Elecrow-RD/AI_Camera_Development_Board_Vision_Sensor_Board_Powered_By_ESP32/factory_firmware/readme.md

# How to install the factory demo firmware with flash download tool?

#### 1.Preparation:

- USB C cable
- Laptop/PC
- ai camera
- Flash download tool

Check whether the materials on the PCBA board are defective. Such as less material, false welding, tin and other bad phenomena.

#### 2.Flash the firmware 

##### Step1 Connect the ESP32 display to the laptop/PC with USB-C cable. The power indicator will light up.

##### Step2 Open the flash download tool. 

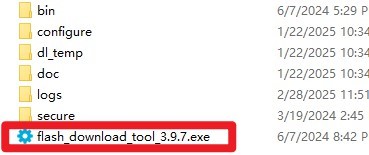
[picture p1: factory_firmware/flash02.jpg]
flash02


For the  Crowpanel Advance HMI ESP32 AI Display, the chip select ESP32-S3:

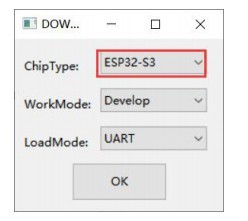
[picture p2: factory_firmware/flash03.jpg]
flash03


##### Step3

①Choose the firmware files;

flash0

②Enter the address: 

boot_app0.bin------0xe000

xxxx.ino.bin--------0x10000

xxxx.ino.bootloader.bin------0x0

xxxx.ino.partitions.bin-------0x8000

③Check the firmware files;

④Select the correct port number;

⑤Click “Start” to download

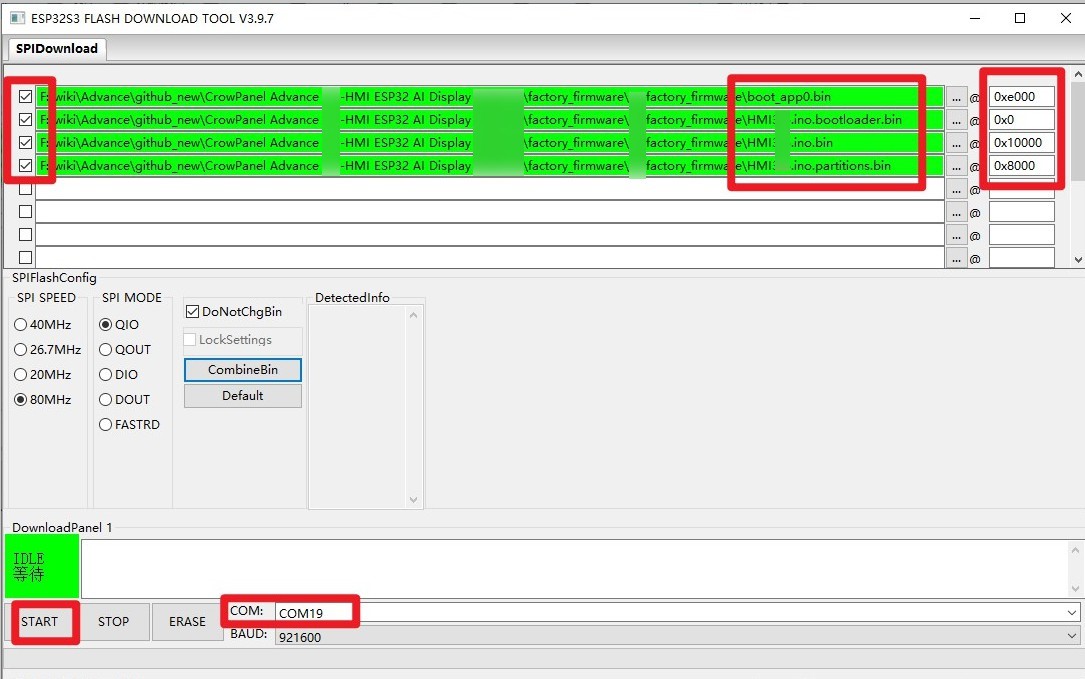
[picture p3: factory_firmware/flash1.jpg]
flash1


##### Step5 After the download is complete, blue FINISH will be displayed, and the progress bar at the bottom shows that it has come to an end.

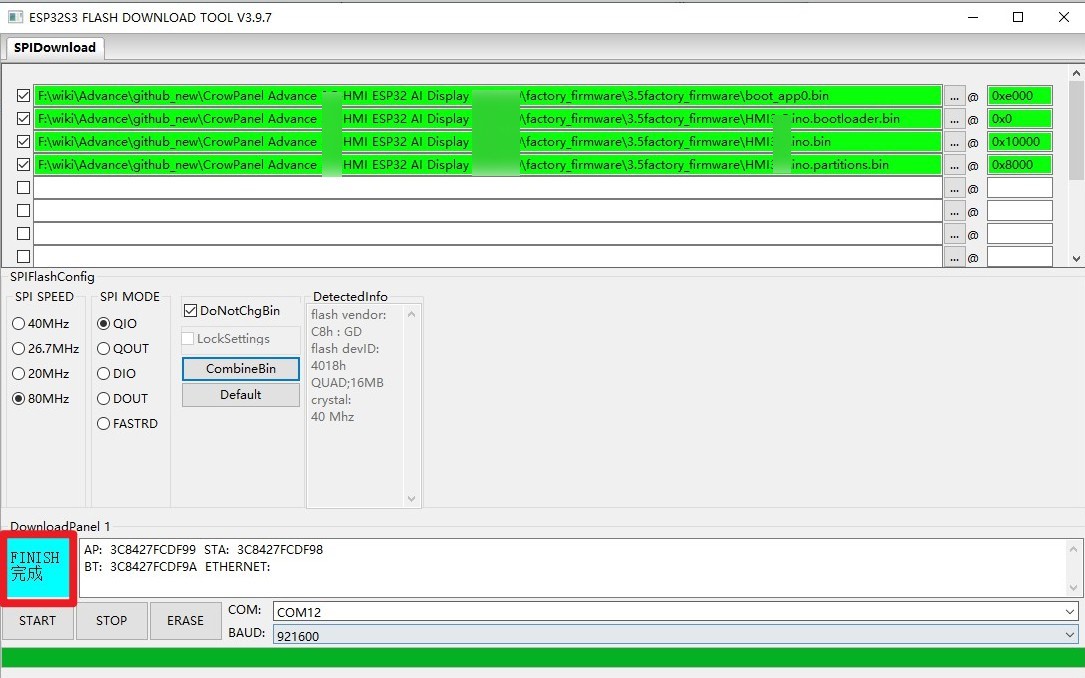
[picture p4: factory_firmware/flash2.jpg]
flash2


##### Step6 Press the reset button to show the demo.
