Elecrow-RD/AI_Camera_Development_Board_Vision_Sensor_Board_Powered_By_ESP32/example/V1.1/AI_Camera_V1.1_Full_Function/AI_Camera-V1.1-Arduino/README.md

# AI_Camera
## 介绍
AI_Camera作为集成AI在线识别和AI聊天机器人的入口，利用大模型的AI能力实现图片识别和在线对话。
## 功能介绍
- 支持HTTP协议发送图片与识别
- 支持Websocket通信协议
- 采用 OPUS 音频编解码
- 基于流式 ASR + LLM + TTS 架构的语音交互
- LCD 显示屏，支持表情显示
- 通过设备端 IOT 实现设备控制（音量、灯光、GPIO 等）
## 硬件版本
- 支持的硬件出货版本：AI_Camera V1.1
## 开发环境
- Arduino IDE 2.3.4
- ESP32版本：3.2.0
- 使用Windows环境开发
## Other
