Elecrow-RD/AI_Camera_Development_Board_Vision_Sensor_Board_Powered_By_ESP32/example/V1.1/AI_Camera_V1.1_Full_Function/AI_Camera-V1.1-Arduino/README_英语（美国）.md

# AI_Camera
## Introduction
AI_Camera serves as an entry point that integrates online AI recognition and an AI chatbot, leveraging the capabilities of large AI models to provide image recognition and online conversations.
## Features
- Supports sending and recognizing images over HTTP
- Supports the WebSocket communication protocol
- Uses the OPUS audio codec
- Voice interaction based on a streaming ASR + LLM + TTS architecture
- LCD display with support for displaying expressions
- Device control through device-side IoT (volume, lighting, GPIO, etc.)
## Hardware Version
- Supported production hardware version: AI_Camera V1.1
## Development Environment
- Arduino IDE 2.3.4
- ESP32 version: 3.2.0
- Developed in a Windows environment
## Other
