Elecrow-RD/AI_Camera_Development_Board_Vision_Sensor_Board_Powered_By_ESP32/factory_firmware/AI-Camear-V1.1-ELECROW-Firmware-20260824/readme.png

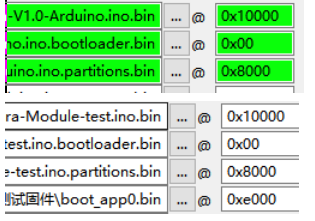
factory_firmware/AI-Camear-V1.1-ELECROW-Firmware-20260824/readme.png
