Elecrow-RD/AI_Camera_Development_Board_Vision_Sensor_Board_Powered_By_ESP32/Eagle_SCH&PCB/1.0/AI Camera V1.0.pdf

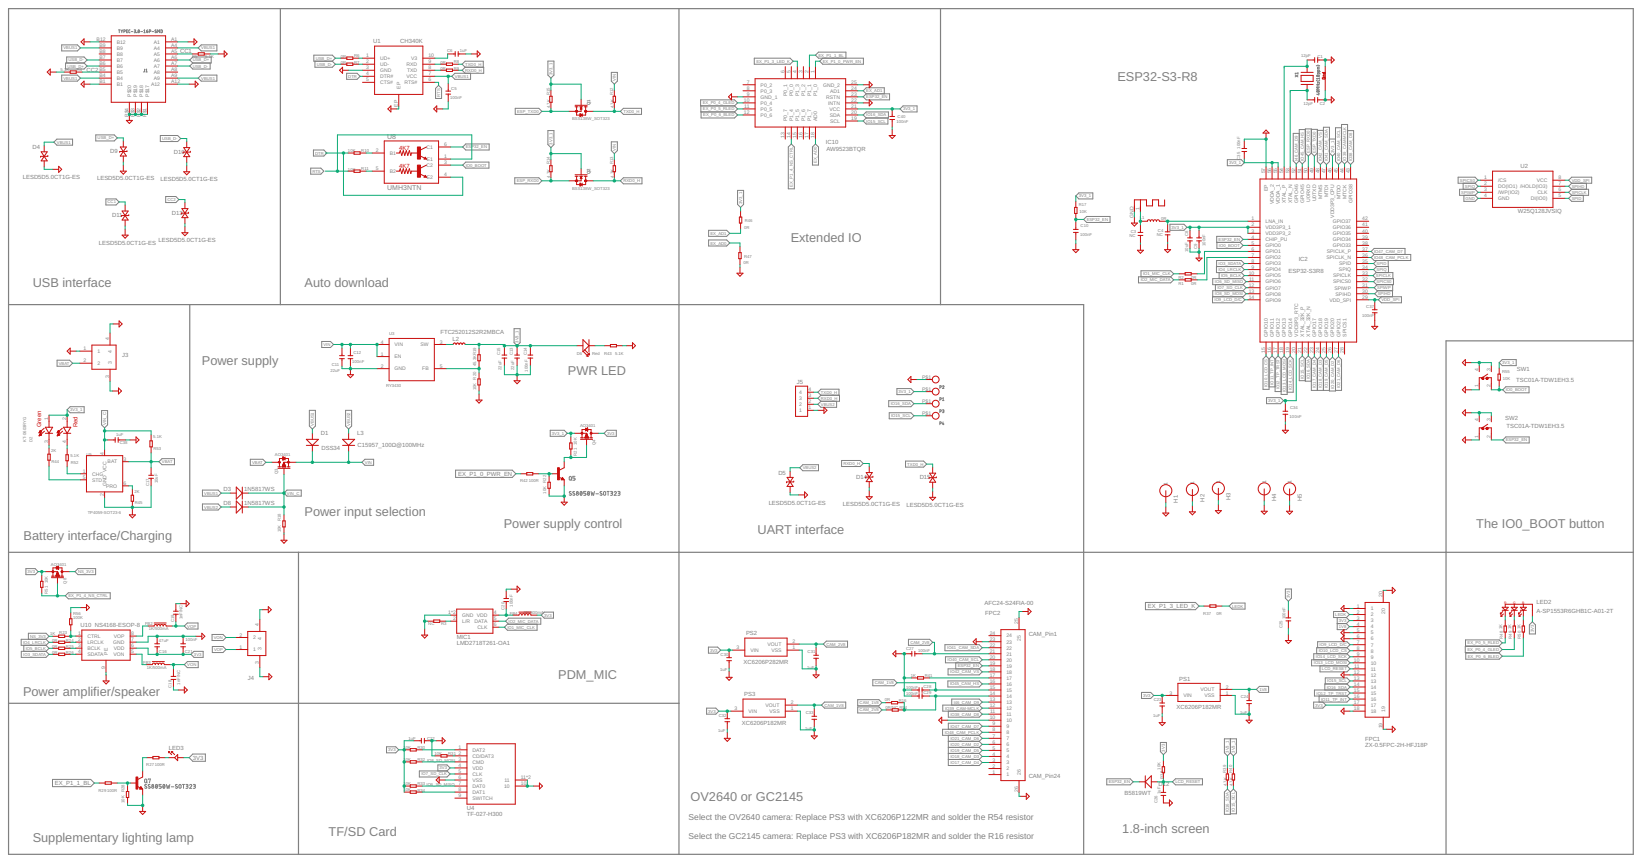
[picture p6: page 1]

The IO0_BOOT button UART interface

Select the OV2640 camera: Replace PS3 with XC6206P122MR and solder the R54 resistor

Select the GC2145 camera: Replace PS3 with XC6206P182MR and solder the R16 resistor
