Elecrow-RD/AI_Camera_Development_Board_Vision_Sensor_Board_Powered_By_ESP32/Eagle_SCH&PCB/1.0/AI Camera V1.0.brd

## EAGLE design Eagle_SCH&PCB/1.0/AI Camera V1.0.brd (2026-04-08)

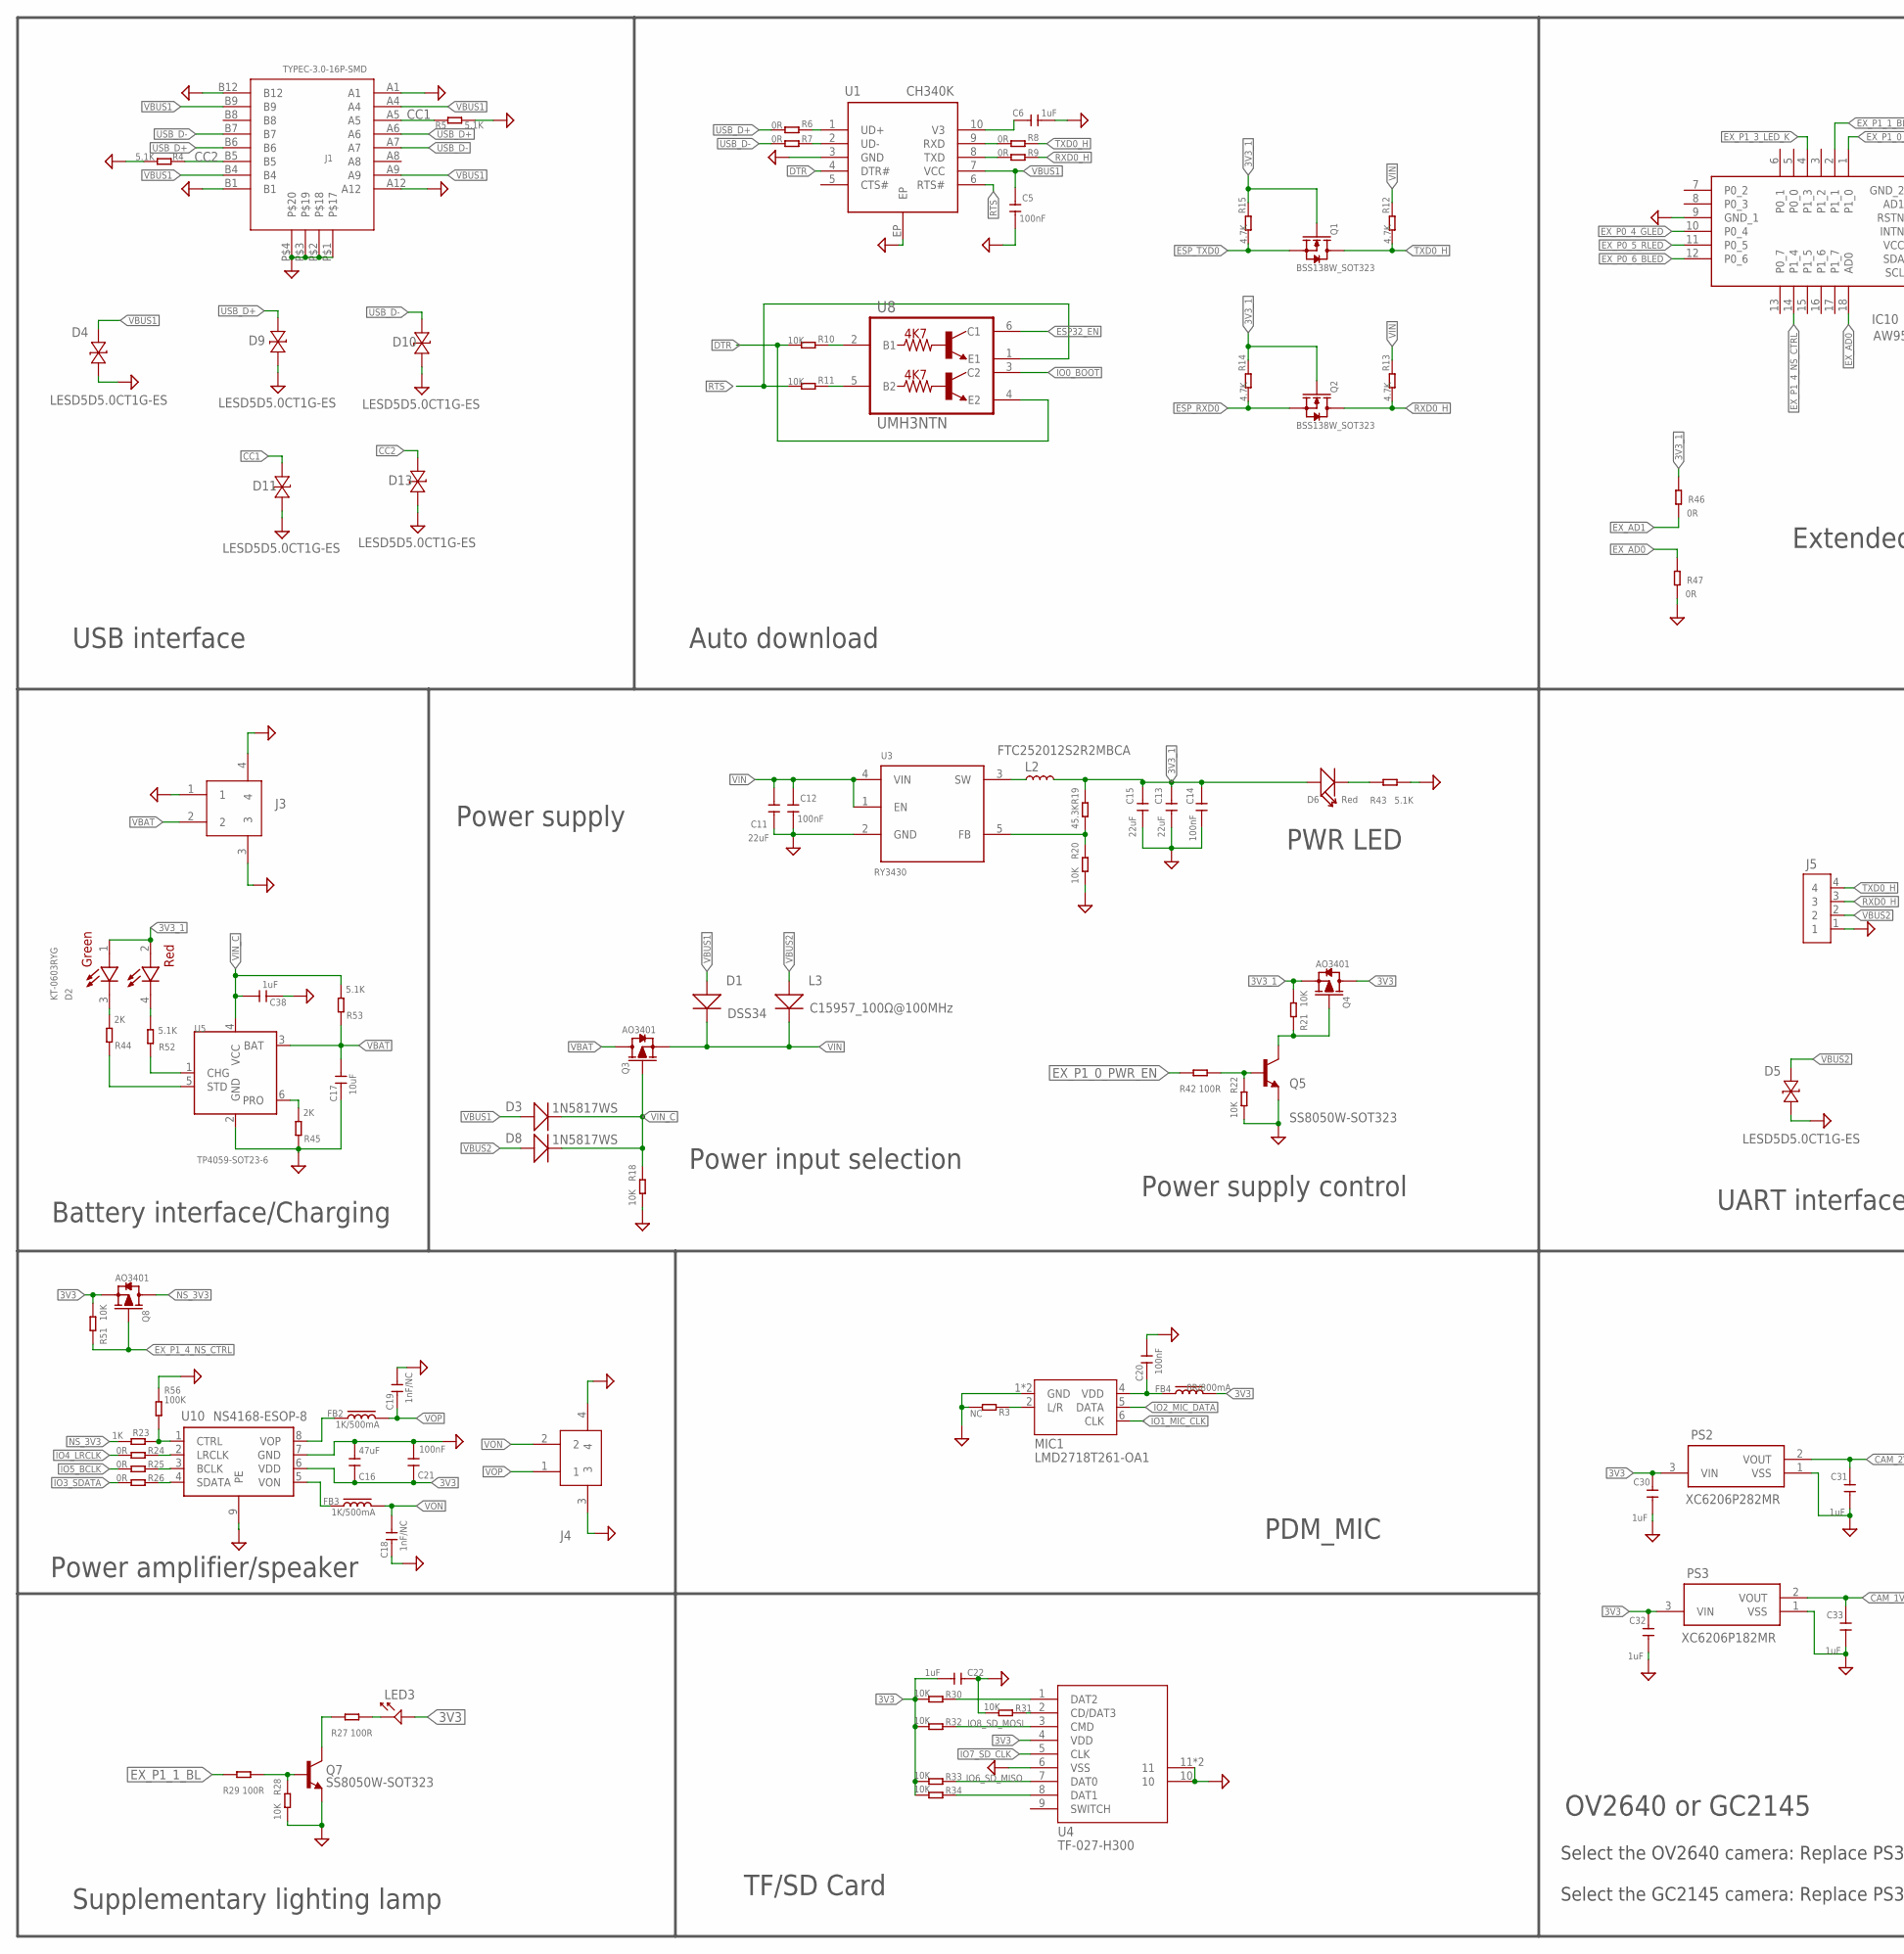
[picture p7: schematic AI Camera V1.0.sch, part in row 1, column 1]

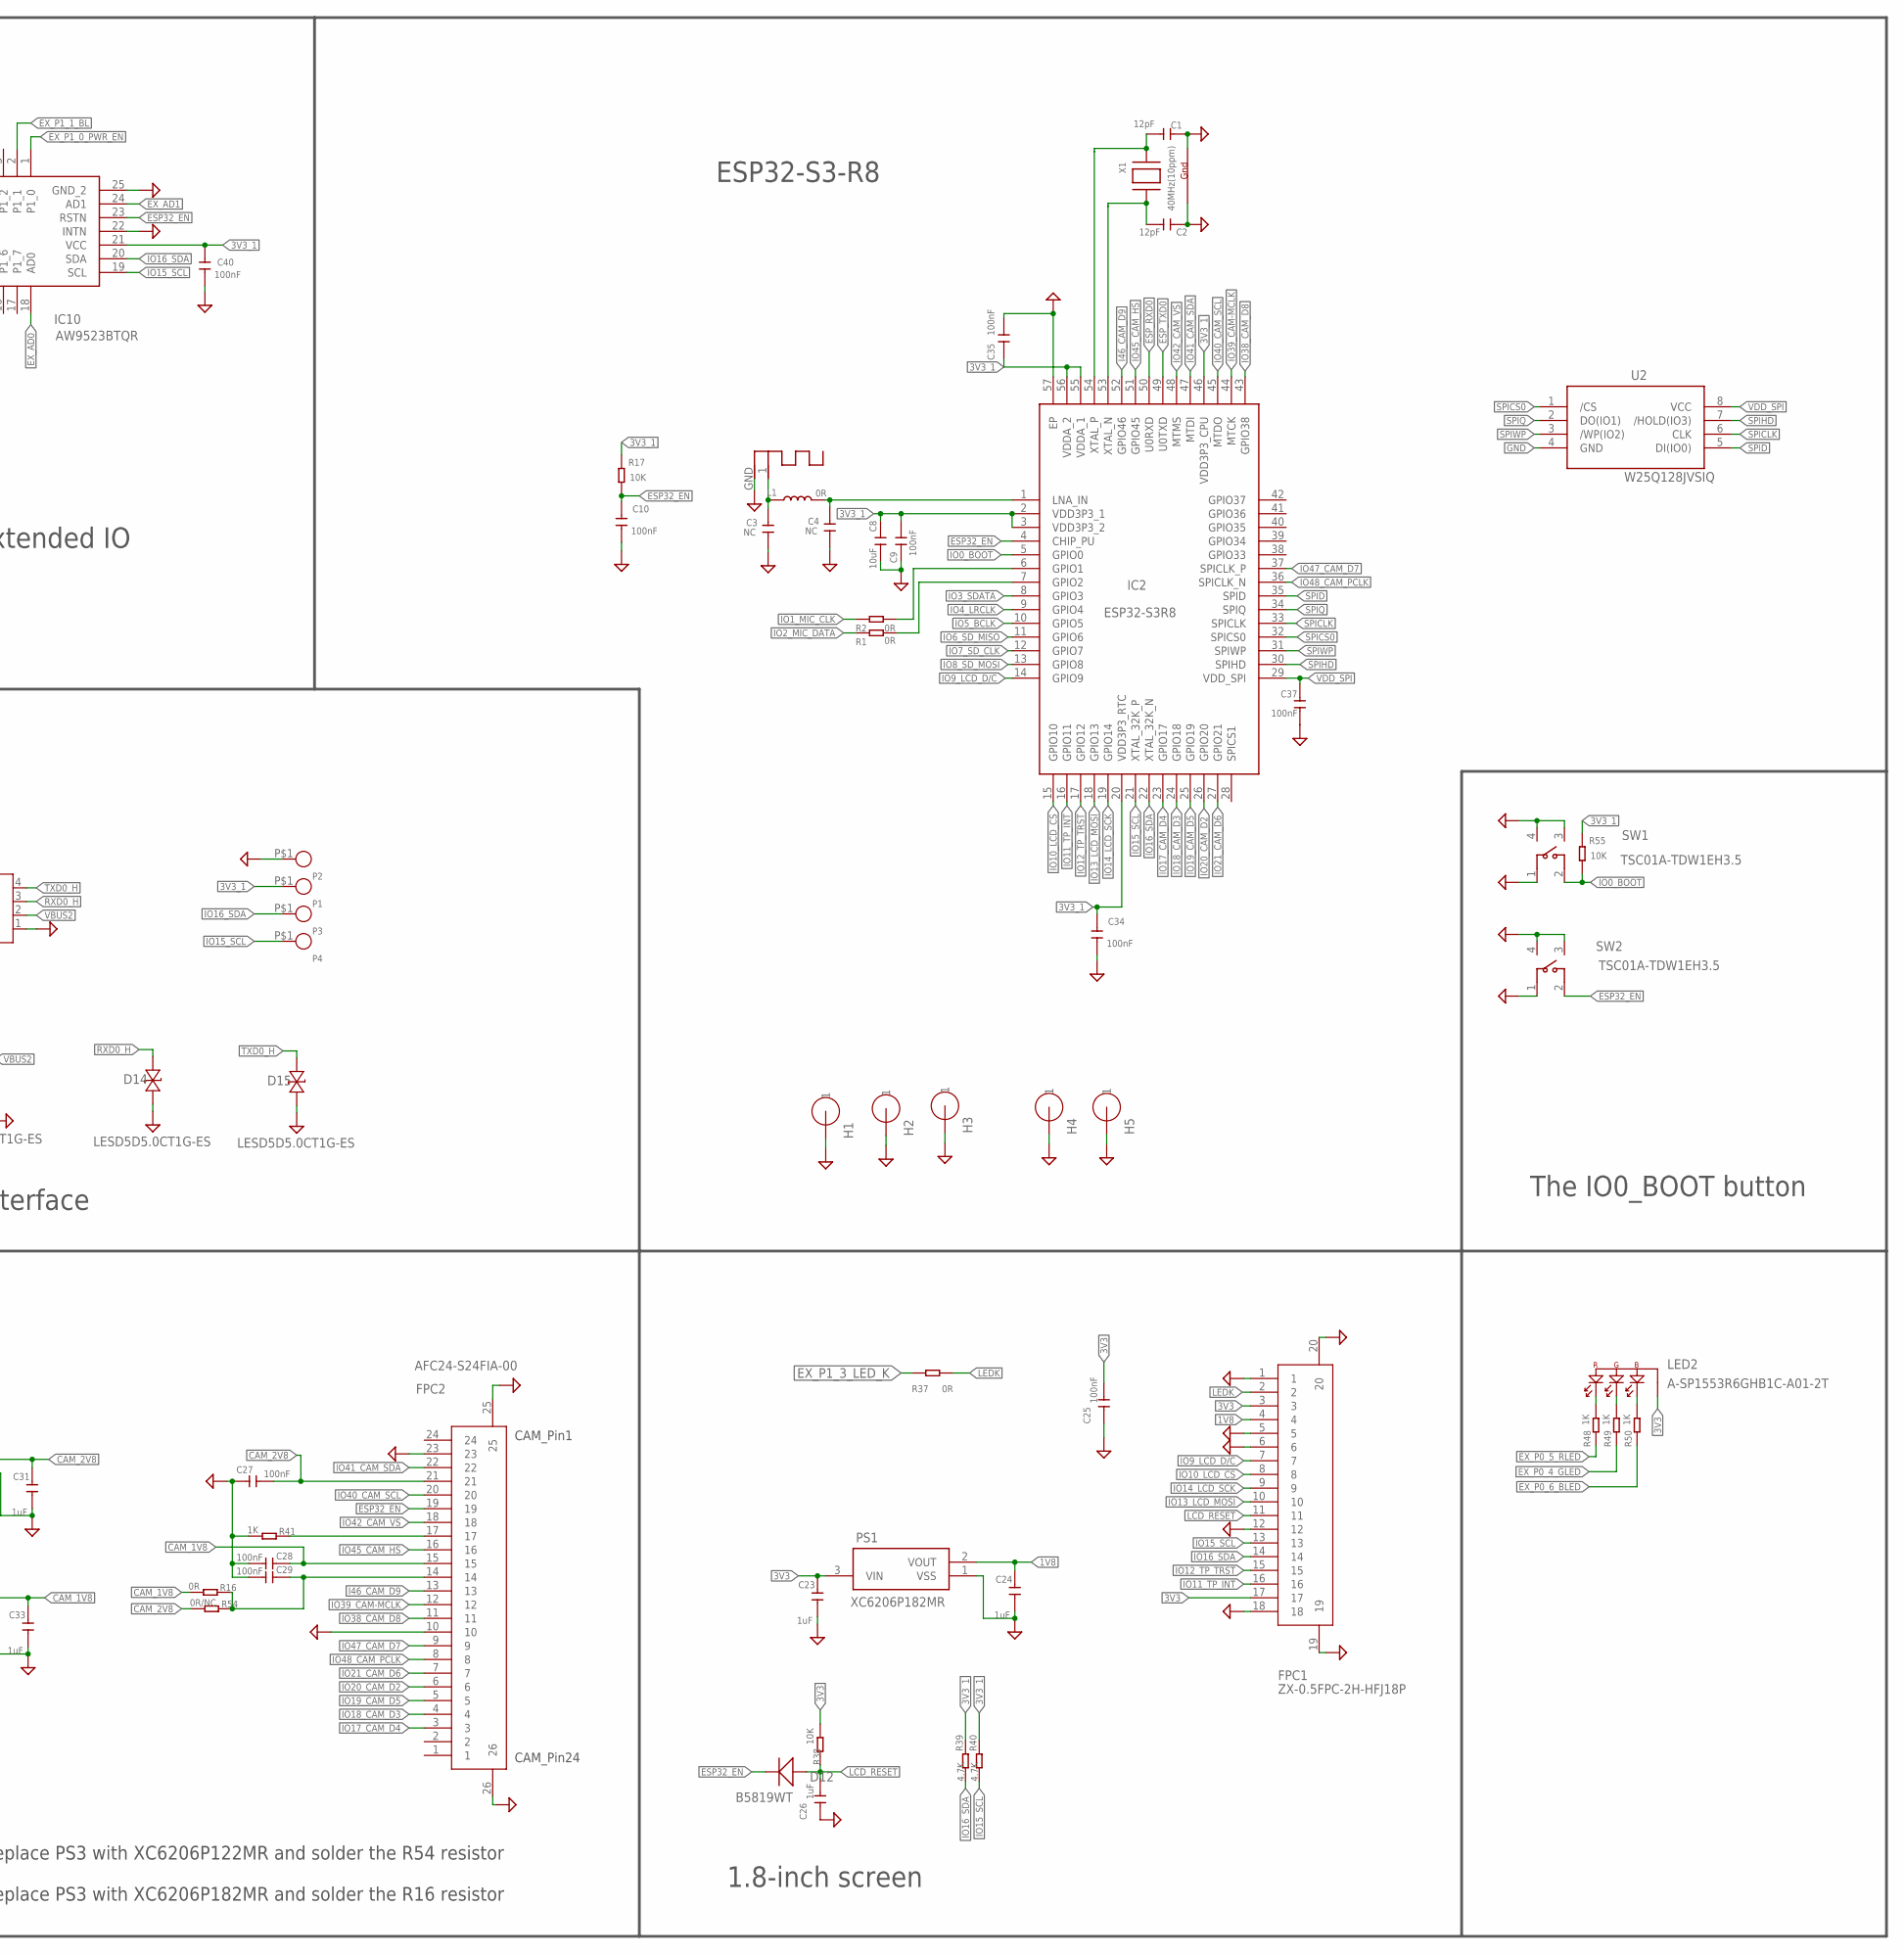
[picture p8: schematic AI Camera V1.0.sch, part in row 1, column 2]

Parts:
ANT1: ADAFRUIT_ANTENNA; ADAFRUIT_RN-ANT
C1, C2: 12pF; C0402
C3, C4: NC; C0402
C5, C9, C10, C12, C14, C20, C21, C25, C27, C28, C29, C34, C35, C37, C40: 100nF; C0402
C6, C22, C23, C24, C26, C30, C31, C32, C33, C38: 1uF; C0402
C8, C17: 10uF; C0402
C11, C13, C15: 22uF; C0603
C16: 47uF; C0805
C18, C19: 1nF/NC; C0402
D1: DSS34; D_SOD123FL
D2: KT-0603RYG; LED_KT-0603RYG
D3, D8: 1N5817WS; D_SOD323
D4, D5, D9, D10, D11, D13, D14, D15: LESD5D5.0CT1G-ES; SOD-523_L1.2-W0.8-LS1.6-BI
D6: Red; LED0603
D12: B5819WT; D_SOD523
FB2, FB3: 1K/500mA; L0603
FB4: 0R/800mA; L0603
FPC1: ZX-0.5FPC-2H-HFJ18P; FPC-SMD_18P-P0.50_ZX-0.5FPC-2H-HFJ18P
FPC2: AFC24-S24FIA-00; FPC-SMD_P0.50-24P_QCHF-SM-H2.0
H1, H2, H3: HOLE; HOLE_M2
H4, H5: HOLE1; LONGSTRIPHOLE
IC2: ESP32-S3R8; QFN40P700X700X90-57N
IC10: AW9523BTQR; QFN50P400X400X80-25N
J1: TYPEC-3.0-16P-SMD; USB-3.0TYPEC-SMD
J3: ZX-SH1.0-2PLT1; CONN-SMD_2P-P1.00_XUNPU_WAFER-SH1.0-2PWB
J4: HC-1.25-2PWT; CONN-SMD_2P-P1.25-HC-1.25-2PWT
J5: HC-HY-4A-M; CONN-TH_4P-P2.00_HCTL_HC-HY-4A
L1: 0R; L0402
L2: FTC252012S2R2MBCA; IND-SMD_L2.5-W2.0_MHCHL2520
L3: C15957_100Ω@100MHz; D_SOD123FL
LED2: A-SP1553R6GHB1C-A01-2T; LED-SMD_4P-L3.2-W2.7-BL_A-SP1553R6GHB1C-A01-2T
LED3: 3014_LED; LED_3014_SMT
MIC1: LMD2718T261-OA1; MIC-SMD_6P-L2.8-W1.9-P0.98-TL
P1, P2, P3, P4: TEST_PADPAD-1.5MM; TEST_PAD-1.5MM
PS1, PS3: XC6206P182MR; SOT95P280X130-3N
PS2: XC6206P282MR; SOT95P280X130-3N
Q1, Q2: BSS138W_SOT323; MOS_SOT323
Q3, Q4, Q8: AO3401; PMOS_SOT23
Q5, Q7: SS8050W-SOT323; MOS_SOT323
R1, R2, R6, R7, R8, R9, R16, R24, R25, R26, R37, R46, R47: 0R; R0402
R3: NC; R0402
R4, R5, R43, R52, R53: 5.1K; R0402
R10, R11, R17, R18, R20, R21, R22, R28, R30, R31, R32, R33, R34, R38, R51, R55: 10K; R0402
R12, R13, R14, R15, R39, R40: 4.7K; R0402
R19: 45.3K; R0402
R23, R41, R48, R49, R50: 1K; R0402
R27, R29, R42: 100R; R0402
R44, R45: 2K; R0402
R54: 0R/NC; R0402
R56: 100K; R0402
SW1, SW2: TSC01A-TDW1EH3.5; KEY-SMD_4P-L4.6-W2.4_TSC01A-TDW1FH3.5
U1: CH340K; ESOP-10-EP-150MIL
U2: W25Q128JVSIQ; CKP_W25QXX-SOP-8-208MIL
U3: RY3430; IC_SOT23-5
U4: TF-027-H300; TF-SMD_HYCW104-TF08-375B
U5: TP4059-SOT23-6; SOT23-6L
U8: UMH3NTN; SOP65P210X100-6N
U10: NS4168-ESOP-8
X1: 40MHz(10ppm); ADAFRUIT_NX3225

Connections:
1V8: C24.1, FPC1.4, PS1.2 (VOUT)
3V3: C16.1, C21.1, C22.2, C23.1, C25.2, C30.1, C32.1, FB4.2, FPC1.3, FPC1.17, LED2.3 (GND), LED3.1, PS1.3 (VIN), PS2.3 (VIN), PS3.3 (VIN), Q4.3 (D), Q8.2 (S), R30.2, R32.2, R33.2, R34.2, R38.2, R51.2, U4.4 (VDD), U10.6 (VDD)
3V3_1: C8.1, C9.2, C13.2, C14.1, C15.2, C34.2, C35.1, C40.2, D2.1, D2.2, D6.+, IC2.2 (VDD3P3_1), IC2.3 (VDD3P3_2), IC2.20 (VDD3P3_RTC), IC2.46 (VDD3P3_CPU), IC2.55 (VDDA_1), IC2.56 (VDDA_2), IC10.21 (VCC), L2.2, P1.P$1, Q1.1 (G), Q2.1 (G), Q4.2 (S), R14.1, R15.1, R17.1, R19.1, R21.2, R39.1, R40.1, R46.1, R55.1
CAM_1V8: C28.1, C33.1, FPC2.15, PS3.2 (VOUT), R16.2
CAM_2V8: C27.1, C31.1, FPC2.21, PS2.2 (VOUT), R54.2
CC1: D11.2, J1.A5, R5.1
CC2: D13.2, J1.B5, R4.1
DOVDD: C29.1, FPC2.14, R16.1, R54.1
DTR: R10.2, U1.4 (DTR#), U8.4 (E2)
ESP32_EN: C10.2, D12.-, FPC2.19, IC2.4 (CHIP_PU), IC10.23 (RSTN), R17.2, SW2.2, U8.6 (C1)
ESP_RXD0: IC2.50 (U0RXD), Q2.2 (S), R14.2
ESP_TXD0: IC2.49 (U0TXD), Q1.2 (S), R15.2
EX_AD0: IC10.18 (AD0), R47.1
EX_AD1: IC10.24 (AD1), R46.2
EX_P0_4_GLED: IC10.10 (P0_4), R49.1
EX_P0_5_RLED: IC10.11 (P0_5), R48.1
EX_P0_6_BLED: IC10.12 (P0_6), R50.1
EX_P1_0_PWR_EN: IC10.1 (P1_0), R42.1
EX_P1_1_BL: IC10.2 (P1_1), R29.1
EX_P1_3_LED_K: IC10.4 (P1_3), R37.1
EX_P1_4_NS_CTRL: IC10.14 (P1_4), Q8.1 (G), R51.1
GND: ANT1.GND, C1.1, C2.1, C3.2, C4.2, C5.2, C6.2, C8.2, C9.1, C10.1, C11.1, C12.2, C13.1, C14.2, C15.1, C16.2, C17.1, C18.1, C19.2, C20.2, C21.2, C22.1, C23.2, C24.2, C25.1, C26.1, C27.2, C28.2, C29.2, C30.2, C31.2, C32.2, C33.2, C34.1, C35.2, C37.1, C38.1, C40.1, D4.1, D5.1, D9.1, D10.1, D11.1, D13.1, D14.1, D15.1, FPC1.1, FPC1.5, FPC1.6, FPC1.12, FPC1.18, FPC1.19, FPC1.20, FPC2.10, FPC2.23, FPC2.25, FPC2.26, H1.1, H2.1, H3.1, H4.1, H4.2, H5.1, H5.2, IC2.57 (EP), IC10.9 (GND_1), IC10.22 (INTN), IC10.25 (GND_2), J1.A1, J1.A12, J1.B1, J1.B12, J1.P$1, J1.P$2, J1.P$3, J1.P$4, J3.1, J3.3, J3.4, J4.3, J4.4, J5.1, MIC1.1 (GND), MIC1.3 (GND), P2.P$1, PS1.1 (VSS), PS2.1 (VSS), PS3.1 (VSS), Q5.2 (E), Q7.2 (E), R3.2, R4.2, R5.2, R18.2, R20.2, R22.2, R28.2, R31.2, R41.2, R43.2, R45.1, R47.2, R56.1, SW1.1, SW1.3, SW1.4, SW2.1, SW2.3, SW2.4, U1.3 (GND), U1.EP, U2.4 (GND), U3.2 (GND), U4.6 (VSS), U4.10, U4.11, U4.12 (11), U5.2 (GND), U10.7 (GND), U10.9 (PE), X1.2 (G2), X1.4 (G1)
I46_CAM_D9: FPC2.13, IC2.52 (GPIO46)
IO0_BOOT: IC2.5 (GPIO0), R55.2, SW1.2, U8.3 (C2)
IO1_MIC_CLK: MIC1.6 (CLK), R1.1
IO2_MIC_DATA: MIC1.5 (DATA), R2.1
IO3_SDATA: IC2.8 (GPIO3), R26.2
IO4_LRCLK: IC2.9 (GPIO4), R24.2
IO5_BCLK: IC2.10 (GPIO5), R25.2
IO6_SD_MISO: IC2.11 (GPIO6), R33.1, U4.7 (DAT0)
IO7_SD_CLK: IC2.12 (GPIO7), U4.5 (CLK)
IO8_SD_MOSI: IC2.13 (GPIO8), R32.1, U4.3 (CMD)
IO9_LCD_D/C: FPC1.7, IC2.14 (GPIO9)
IO10_LCD_CS: FPC1.8, IC2.15 (GPIO10)
IO11_TP_INT: FPC1.16, IC2.16 (GPIO11)
IO12_TP_TRST: FPC1.15, IC2.17 (GPIO12)
IO13_LCD_MOSI: FPC1.10, IC2.18 (GPIO13)
IO14_LCD_SCK: FPC1.9, IC2.19 (GPIO14)
IO15_SCL: FPC1.13, IC2.21 (XTAL_32K_P), IC10.19 (SCL), P4.P$1, R40.2
IO16_SDA: FPC1.14, IC2.22 (XTAL_32K_N), IC10.20 (SDA), P3.P$1, R39.2
IO17_CAM_D4: FPC2.3, IC2.23 (GPIO17)
IO18_CAM_D3: FPC2.4, IC2.24 (GPIO18)
IO19_CAM_D5: FPC2.5, IC2.25 (GPIO19)
IO20_CAM_D2: FPC2.6, IC2.26 (GPIO20)
IO21_CAM_D6: FPC2.7, IC2.27 (GPIO21)
IO38_CAM_D8: FPC2.11, IC2.43 (GPIO38)
IO39_CAM-MCLK: FPC2.12, IC2.44 (MTCK)
IO40_CAM_SCL: FPC2.20, IC2.45 (MTDO)
IO41_CAM_SDA: FPC2.22, IC2.47 (MTDI)
IO42_CAM_VS: FPC2.18, IC2.48 (MTMS)
IO45_CAM_HS: FPC2.16, IC2.51 (GPIO45)
IO47_CAM_D7: FPC2.9, IC2.37 (SPICLK_P)
IO48_CAM_PCLK: FPC2.8, IC2.36 (SPICLK_N)
LCD_RESET: C26.2, D12.+, FPC1.11, R38.1
LEDK: FPC1.2, R37.2
unnamed: IC2.6 (GPIO1), R1.2
unnamed: R31.1, U4.2 (CD/DAT3)
unnamed: MIC1.2 (L/R), R3.1
unnamed: ANT1.1 (FEED), C3.1, L1.1
unnamed: C4.1, IC2.1 (LNA_IN), L1.2
unnamed: D6.-, R43.1
unnamed: D2.4, R52.2
unnamed: R7.1, U1.2 (UD-)
unnamed: R6.1, U1.1 (UD+)
unnamed: R8.2, U1.9 (RXD)
unnamed: R9.2, U1.8 (TXD)
unnamed: R10.1, U8.2 (B1)
unnamed: R11.1, U8.5 (B2)
unnamed: C6.1, U1.10 (V3)
unnamed: IC2.7 (GPIO2), R2.2
unnamed: R52.1, U5.1 (CHG)
unnamed: L2.1, U3.3 (SW)
unnamed: C2.2, IC2.53 (XTAL_N), X1.3 (X2)
unnamed: R19.2, R20.1, U3.5 (FB)
unnamed: R24.1, U10.2 (LRCLK)
unnamed: R25.1, U10.3 (BCLK)
unnamed: R26.1, U10.4 (SDATA)
unnamed: Q4.1 (G), Q5.3 (C), R21.1
unnamed: Q5.1 (B), R22.1, R42.2
unnamed: R45.2, U5.6 (PRO)
unnamed: FB3.1, U10.5 (VON)
unnamed: FB2.1, U10.8 (VOP)
unnamed: C20.1, FB4.1, MIC1.4 (VDD)
unnamed: LED3.2, R27.2
unnamed: Q7.3 (C), R27.1
unnamed: Q7.1 (B), R28.1, R29.2
unnamed: LED2.2 (R), R48.2
unnamed: R30.1, U4.1 (DAT2)
unnamed: C1.2, IC2.54 (XTAL_P), X1.1 (X1)
unnamed: FPC2.17, R41.1
unnamed: LED2.1 (G), R49.2
unnamed: LED2.4 (B), R50.2
unnamed: R34.1, U4.8 (DAT1)
unnamed: D2.3, R44.2
unnamed: R44.1, U5.5 (STD)
NS_3V3: Q8.3 (D), R23.2
NS_CTRL: R23.1, R56.2, U10.1 (CTRL)
RTS: R11.2, U1.6 (RTS#), U8.1 (E1)
RXD0_H: D14.2, J5.3, Q2.3 (D), R9.1, R13.2
SPICLK: IC2.33 (SPICLK), U2.6 (CLK)
SPICS0: IC2.32 (SPICS0), U2.1 (/CS)
SPID: IC2.35 (SPID), U2.5 (DI(IO0))
SPIHD: IC2.30 (SPIHD), U2.7 (/HOLD(IO3))
SPIQ: IC2.34 (SPIQ), U2.2 (DO(IO1))
SPIWP: IC2.31 (SPIWP), U2.3 (/WP(IO2))
TXD0_H: D15.2, J5.4, Q1.3 (D), R8.1, R12.2
USB_D+: D9.2, J1.A6, J1.B6, R6.2
USB_D-: D10.2, J1.A7, J1.B7, R7.2
VBAT: C17.2, J3.2, Q3.3 (D), R53.1, U5.3 (BAT)
VBUS1: C5.1, D1.+, D3.+, D4.2, J1.A4, J1.A9, J1.B4, J1.B9, U1.7 (VCC)
VBUS2: D5.2, D8.+, J5.2, L3.+
VDD_SPI: C37.2, IC2.29 (VDD_SPI), U2.8 (VCC)
VIN: C11.2, C12.1, D1.-, L3.-, Q3.2 (S), R12.1, R13.1, U3.1 (EN), U3.4 (VIN)
VIN_C: C38.2, D3.-, D8.-, Q3.1 (G), R18.1, R53.2, U5.4 (VCC)
VON: C18.2, FB3.2, J4.2
VOP: C19.1, FB2.2, J4.1

Notes on the sheet:
USB interface
Auto download
ESP32-S3-R8
The IO0_BOOT button
UART interface
Power supply
Power input selection
Power supply control
Battery interface/Charging
Power amplifier/speaker
Supplementary lighting lamp
TF/SD Card
OV2640 or GC2145
1.8-inch screen
PDM_MIC
PWR LED
Extended IO
Select the OV2640 camera: Replace PS3 with XC6206P122MR and solder the R54 resistor Select the GC2145 camera: Replace PS3 with XC6206P182MR and solder the R16 resistor
CAM_Pin1
CAM_Pin24

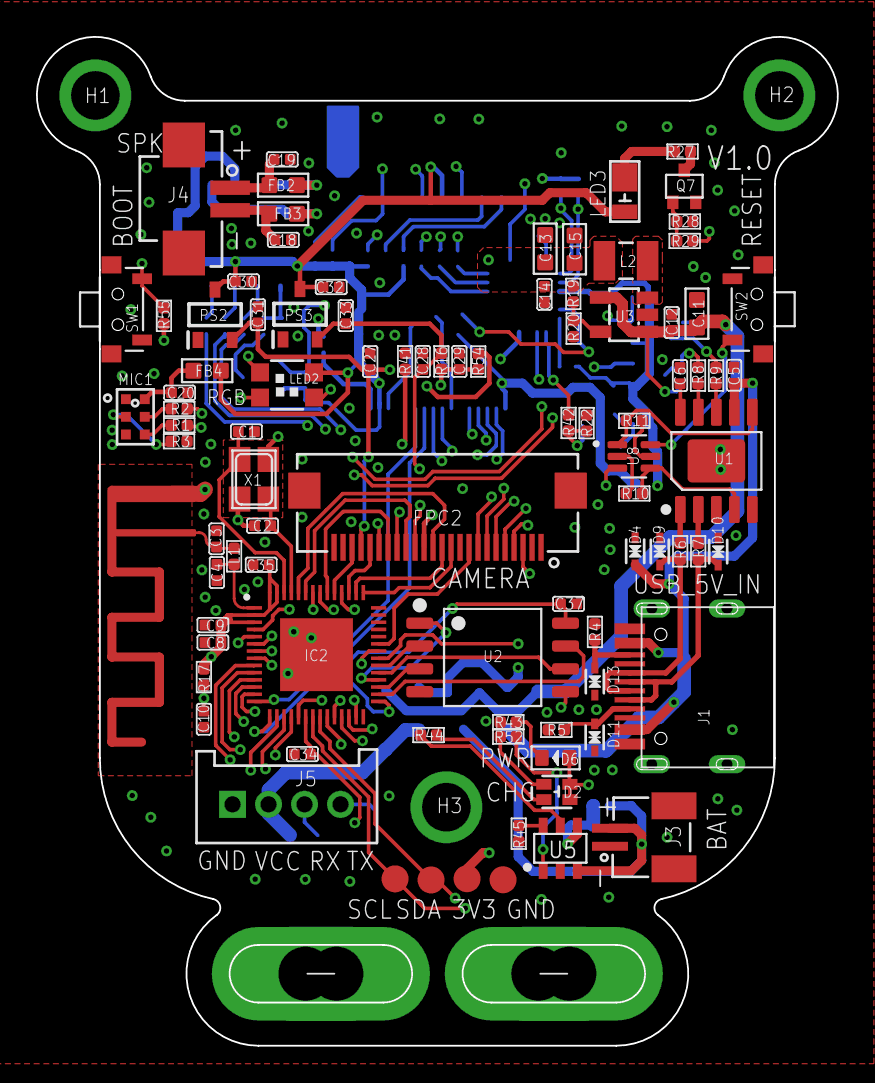
[picture p9: board AI Camera V1.0.brd from above]

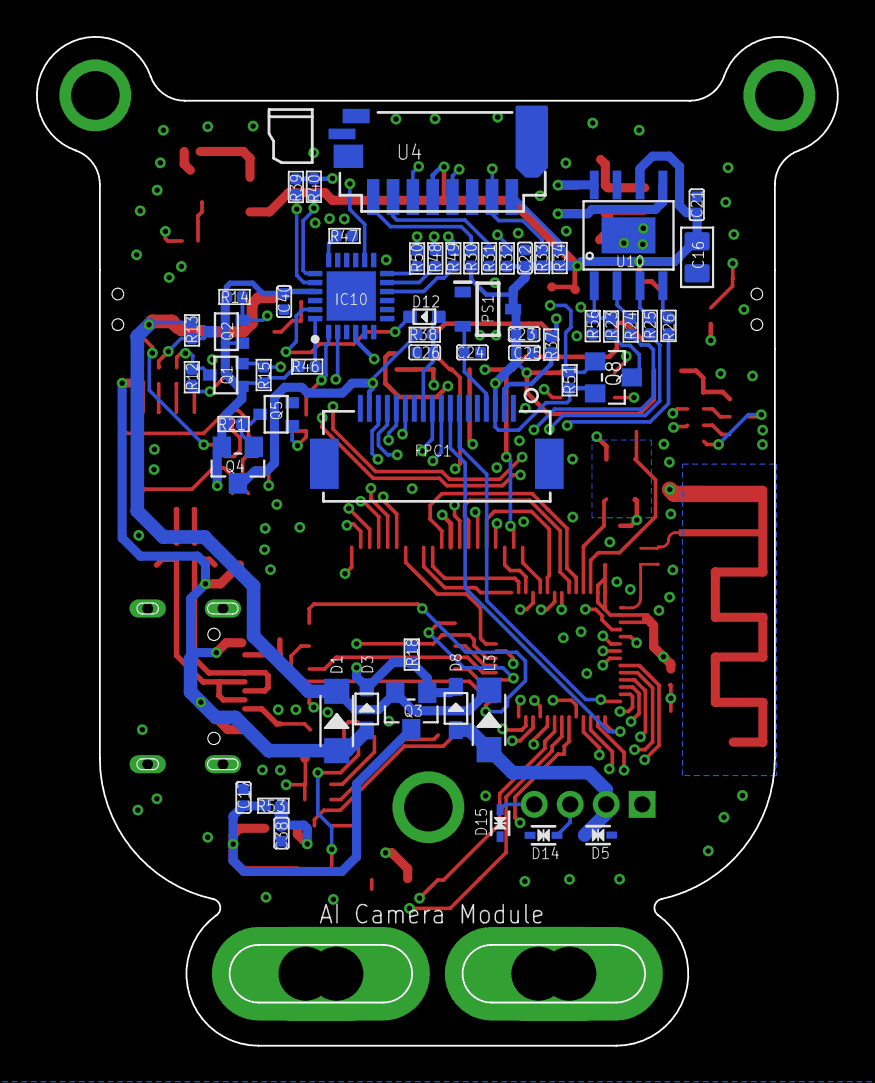
[picture p10: board AI Camera V1.0.brd from below]

Board: 4 copper layers, 44.5 x 56.0 mm, 152 parts (56 on the bottom side), 116 nets.
