Elecrow-RD/AI_Camera_Development_Board_Vision_Sensor_Board_Powered_By_ESP32/example/V1.1/AI_Camera_V1.1_Full_Function/AI_Camera-V1.1-Arduino/src/SD/elecrow_sd.h

#ifndef _ELECROW_SD_H
#define _ELECROW_SD_H

#include <SPI.h>
#include <SD.h>

class ELECROW_SD
{
  public:

    enum SD_Save_Result { SAVE_OK, ERR_OPEN, ERR_WRITE, ERR_NOT_INSERTED };

    ELECROW_SD(int SPI_SCK,int SPI_MISO,int SPI_MOSI,int SPI_NSS);

    ~ELECROW_SD(){};
    
    bool SD_init(void);

    void listDir(fs::FS & fs, const char *dirname, uint8_t levels);

    void createDir(fs::FS & fs, const char *path);

    void removeDir(fs::FS & fs, const char *path);

    void createFile(fs::FS & fs,const char *path);

    void readFile(fs::FS & fs, const char *path);

    void writeFile(fs::FS & fs, const char *path, const char *message);

    void appendFile(fs::FS & fs, const char *path, const char *message);

    void renameFile(fs::FS & fs, const char *path1, const char *path2);

    void deleteFile(fs::FS & fs, const char *path);

    SD_Save_Result save_rgb565_to_bmp(fs::FS &fs,
                               const char *path,
                               const uint16_t *rgb565,
                               int width,
                               int height);

    void SD_test(void);

    void SD_End();

  protected:

  private:
    int SD_SCK_PIN; 

    int SD_MISO_PIN;

    int SD_MOSI_PIN;

    int SD_NSS_PIN;
};

#endif
